agrif/bluegrass/README.md

Bluegrass Rev.1 Logo

This is an STM32 board (a la "Blue Pill") with built-in circuitry to charge
a single-cell lithium battery, over USB or DC input. It provides 5V and 3.3V
both at 1A, low standby current, battery fuel gauging, and supports charging
from a solar panel.
