agrif/bluegrass/logo/README.md

Bluegrass Rev.1 Logo

This logo uses [Wooden Nickel NF][] by [Nick Curtis][], with white
lines added on top for no better reason than I think they look nice
in PCB silkscreen. Nick makes nice fonts, and a ton of them are
free -- thank you Nick!

  [Wooden Nickel NF]: https://www.1001fonts.com/woodennickelblack-font.html
  [Nick Curtis]: https://www.nicksfonts.com/
