agrif/bluegrass/hardware/stm32-battery.kicad_pcb

## KiCad design hardware/stm32-battery.kicad_pcb (2022-09-16)

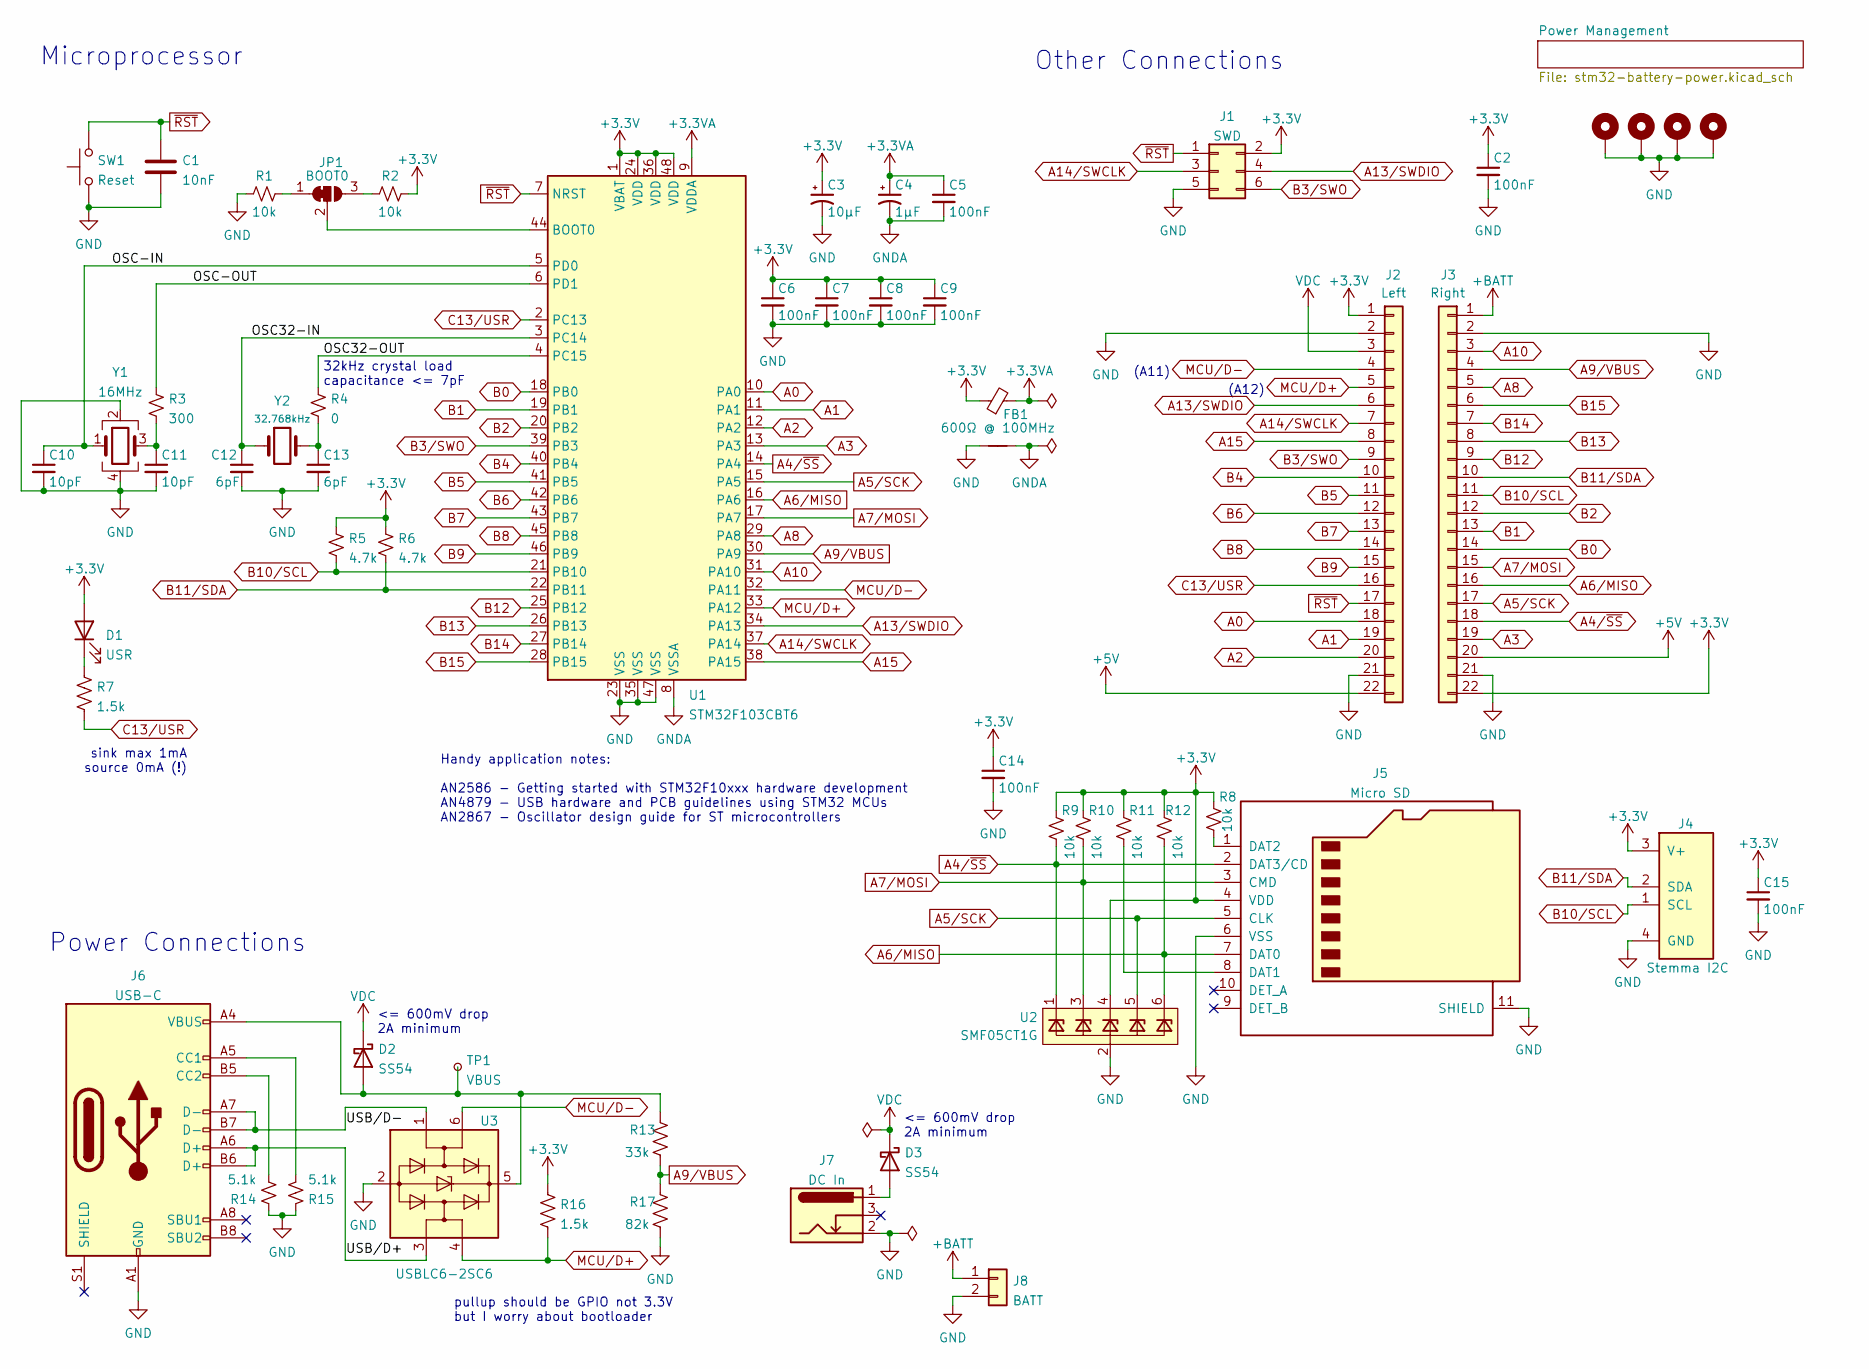
[picture p1: schematic stm32-battery.kicad_sch, STM32 with Battery]

Parts:
C1: 10nF; C_0805_2012Metric; LCSC Part # C1710
C2, C5, C6, C7, C8, C9, C14, C15: 100nF; C_0603_1608Metric; LCSC Part # C14663
C3: 10µF; C_0805_2012Metric; LCSC Part # C15850
C4: 1µF; C_0805_2012Metric; LCSC Part # C28323
C10, C11: 10pF; C_0603_1608Metric; LCSC Part # C1634
C12, C13: 6pF; C_0603_1608Metric; LCSC Part # C37474
D1: USR; LED_0805_2012Metric; LCSC Part # C2296
D2, D3: SS54; D_SMA; LCSC Part # C22452
FB1: 600Ω @ 100MHz; L_0805_2012Metric; LCSC Part # C1017
H1, H2, H3, H4: M3; MountingHole_3.2mm_M3_Pad
J1: SWD; PinHeader_2x03_P2.54mm_Vertical
J2: Left; PinHeader_1x22_P2.54mm_Vertical
J3: Right; PinHeader_1x22_P2.54mm_Vertical
J4: Stemma I2C; JST_PH_S4B-PH-K_1x04_P2.00mm_Horizontal; Digikey # S4B-PH-KL(LF)(SN)-ND
J5: Micro SD; SOFNG-TF-15x15; LCSC Part # C111196
J6: USB-C; USB_C_Receptacle_XKB_U262-16XN-4BVC11; LCSC Part # C319148
J7: DC In; BarrelJack_Horizontal; Mouser # 992-CON-SOCJ-2155; Digikey # 1939-G-014-4-ND
J8: BATT; JST_PH_S2B-PH-K_1x02_P2.00mm_Horizontal; Digikey # S2B-PH-K-S(LF)(SN)
JP1: BOOT0; SolderJumper-3_P1.3mm_Bridged12_RoundedPad1.0x1.5mm
NT1: NetTie_2; NetTie-2_SMD_Pad2.0mm
R1, R2, R8, R9, R10, R11, R12: 10k; R_0603_1608Metric; LCSC Part # C25804
R3: 300; R_0603_1608Metric; LCSC Part # C23025
R4: 0; R_0603_1608Metric; LCSC Part # C21189
R5, R6: 4.7k; R_0603_1608Metric; LCSC Part # C23162
R7, R16: 1.5k; R_0603_1608Metric; LCSC Part # C22843
R13: 33k; R_0603_1608Metric; LCSC Part # C4216
R14, R15: 5.1k; R_0603_1608Metric; LCSC Part # C23186
R17: 82k; R_0603_1608Metric; LCSC Part # C23254
SW1: Reset; TS-1187A-B-A-B; LCSC Part # C318884
TP1: VBUS; TestPoint_THTPad_D1.0mm_Drill0.5mm
U1: STM32F103CBT6; LQFP-48_7x7mm_P0.5mm; LCSC Part # C8304
U2: SMF05CT1G; SOT-363_SC-70-6; LCSC Part # C15879
U3: USBLC6-2SC6; SOT-23-6; LCSC Part # C2827654
Y1: 16MHz; Crystal_SMD_3225-4Pin_3.2x2.5mm; LCSC Part # C13738
Y2: 32.768kHz; Crystal_SMD_2012-2Pin_2.0x1.2mm; LCSC Part # C97602

Connections:
+3.3VA: C4.1, C5.1, FB1.2, U1.9 (VDDA)
+3V3: C2.1, C3.1, C6.1, C7.1, C8.1, C9.1, C14.1, C15.1, D1.2 (A), FB1.1, J1.2, J2.1, J3.22, J4.3 (V+), J5.4 (VDD), R2.2, R5.1, R6.1, R8.1, R9.1, R10.1, R11.1, R12.1, R16.1, U1.1 (VBAT), U1.24 (VDD), U1.36 (VDD), U1.48 (VDD), U2.4 (K); also elsewhere on the board
+5V: J2.22, J3.20; also elsewhere on the board
+BATT: J3.1, J8.1; also elsewhere on the board
/OSC32-IN: C12.1, U1.3 (PC14), Y2.1
/OSC32-OUT: R4.1, U1.4 (PC15)
/OSC-IN: C10.1, U1.5 (PD0), Y1.1
/OSC-OUT: R3.1, U1.6 (PD1)
/USB/D+: J6.A6 (D+), J6.B6 (D+), U3.3 (I/O2)
/USB/D-: J6.A7 (D-), J6.B7 (D-), U3.1 (I/O1)
A0: J2.18, U1.10 (PA0)
A1: J2.19, U1.11 (PA1)
A2: J2.20, U1.12 (PA2)
A3: J3.19, U1.13 (PA3)
A4/~SS: J3.18, J5.2 (DAT3/CD), R9.2, U1.14 (PA4), U2.1 (K)
A5/SCK: J3.17, J5.5 (CLK), U1.15 (PA5), U2.5 (K)
A6/MISO: J3.16, J5.7 (DAT0), R12.2, U1.16 (PA6), U2.6 (K)
A7/MOSI: J3.15, J5.3 (CMD), R10.2, U1.17 (PA7), U2.3 (K)
A8: J3.5, U1.29 (PA8)
A9/VBUS: J3.4, R13.2, R17.1, U1.30 (PA9)
A10: J3.3, U1.31 (PA10)
A13/SWDIO: J1.4, J2.6, U1.34 (PA13)
A14/SWCLK: J1.3, J2.7, U1.37 (PA14)
A15: J2.8, U1.38 (PA15)
B0: J3.14, U1.18 (PB0)
B1: J3.13, U1.19 (PB1)
B2: J3.12, U1.20 (PB2)
B3/SWO: J1.6, J2.9, U1.39 (PB3)
B4: J2.10, U1.40 (PB4)
B5: J2.11, U1.41 (PB5)
B6: J2.12, U1.42 (PB6)
B7: J2.13, U1.43 (PB7)
B8: J2.14, U1.45 (PB8)
B9: J2.15, U1.46 (PB9)
B10/SCL: J3.11, J4.1 (SCL), R5.2, U1.21 (PB10); also elsewhere on the board
B11/SDA: J3.10, J4.2 (SDA), R6.2, U1.22 (PB11); also elsewhere on the board
B12: J3.9, U1.25 (PB12)
B13: J3.8, U1.26 (PB13)
B14: J3.7, U1.27 (PB14)
B15: J3.6, U1.28 (PB15)
C13/USR: J2.16, R7.2, U1.2 (PC13)
GND: C1.2, C2.2, C3.2, C6.2, C7.2, C8.2, C9.2, C10.2, C11.2, C12.2, C13.2, C14.2, C15.2, H1.1, H2.1, H3.1, H4.1, J1.5, J2.2, J2.21, J3.2, J3.21, J4.4 (GND), J5.6 (VSS), J5.11 (SHIELD), J6.A1 (GND), J6.A12 (GND), J6.B1 (GND), J6.B12 (GND), J7.2, J8.2, NT1.1, R1.1, R14.1, R15.1, R17.2, SW1.1, U1.23 (VSS), U1.35 (VSS), U1.47 (VSS), U2.2 (A), U3.2 (GND), Y1.2, Y1.4; also elsewhere on the board
GNDA: C4.2, C5.2, NT1.2, U1.8 (VSSA)
MCU/D+: J2.5, R16.2, U1.33 (PA12), U3.4 (I/O2)
MCU/D-: J2.4, U1.32 (PA11), U3.6 (I/O1)
unnamed: C11.1, R3.2, Y1.3
unnamed: C13.1, R4.2, Y2.2
unnamed: D1.1 (K), R7.1
unnamed: D2.2 (A), J6.A4 (VBUS), J6.A9 (VBUS), J6.B4 (VBUS), J6.B9 (VBUS), R13.1, TP1.1, U3.5 (VBUS)
unnamed: D3.2 (A), J7.1
unnamed: J5.1 (DAT2), R8.2
unnamed: J5.8 (DAT1), R11.2
unnamed: J6.A5 (CC1), R15.2
unnamed: J6.B5 (CC2), R14.2
unnamed: JP1.1 (A), R1.2
unnamed: JP1.2 (C), U1.44 (BOOT0)
unnamed: JP1.3 (B), R2.1
VDC: D2.1 (K), D3.1 (K), J2.3; also elsewhere on the board
~RST: C1.1, J1.1, J2.17, SW1.2, U1.7 (NRST)

Notes on the sheet:
Power Connections
sink max 1mA source 0mA (!)
pullup should be GPIO not 3.3V but I worry about bootloader
(A12)
Other Connections
32kHz crystal load capacitance <= 7pF
Microprocessor
<= 600mV drop 2A minimum
Handy application notes: AN2586 - Getting started with STM32F10xxx hardware development AN4879 - USB hardware and PCB guidelines using STM32 MCUs AN2867 - Oscillator design guide for ST microcontrollers
(A11)

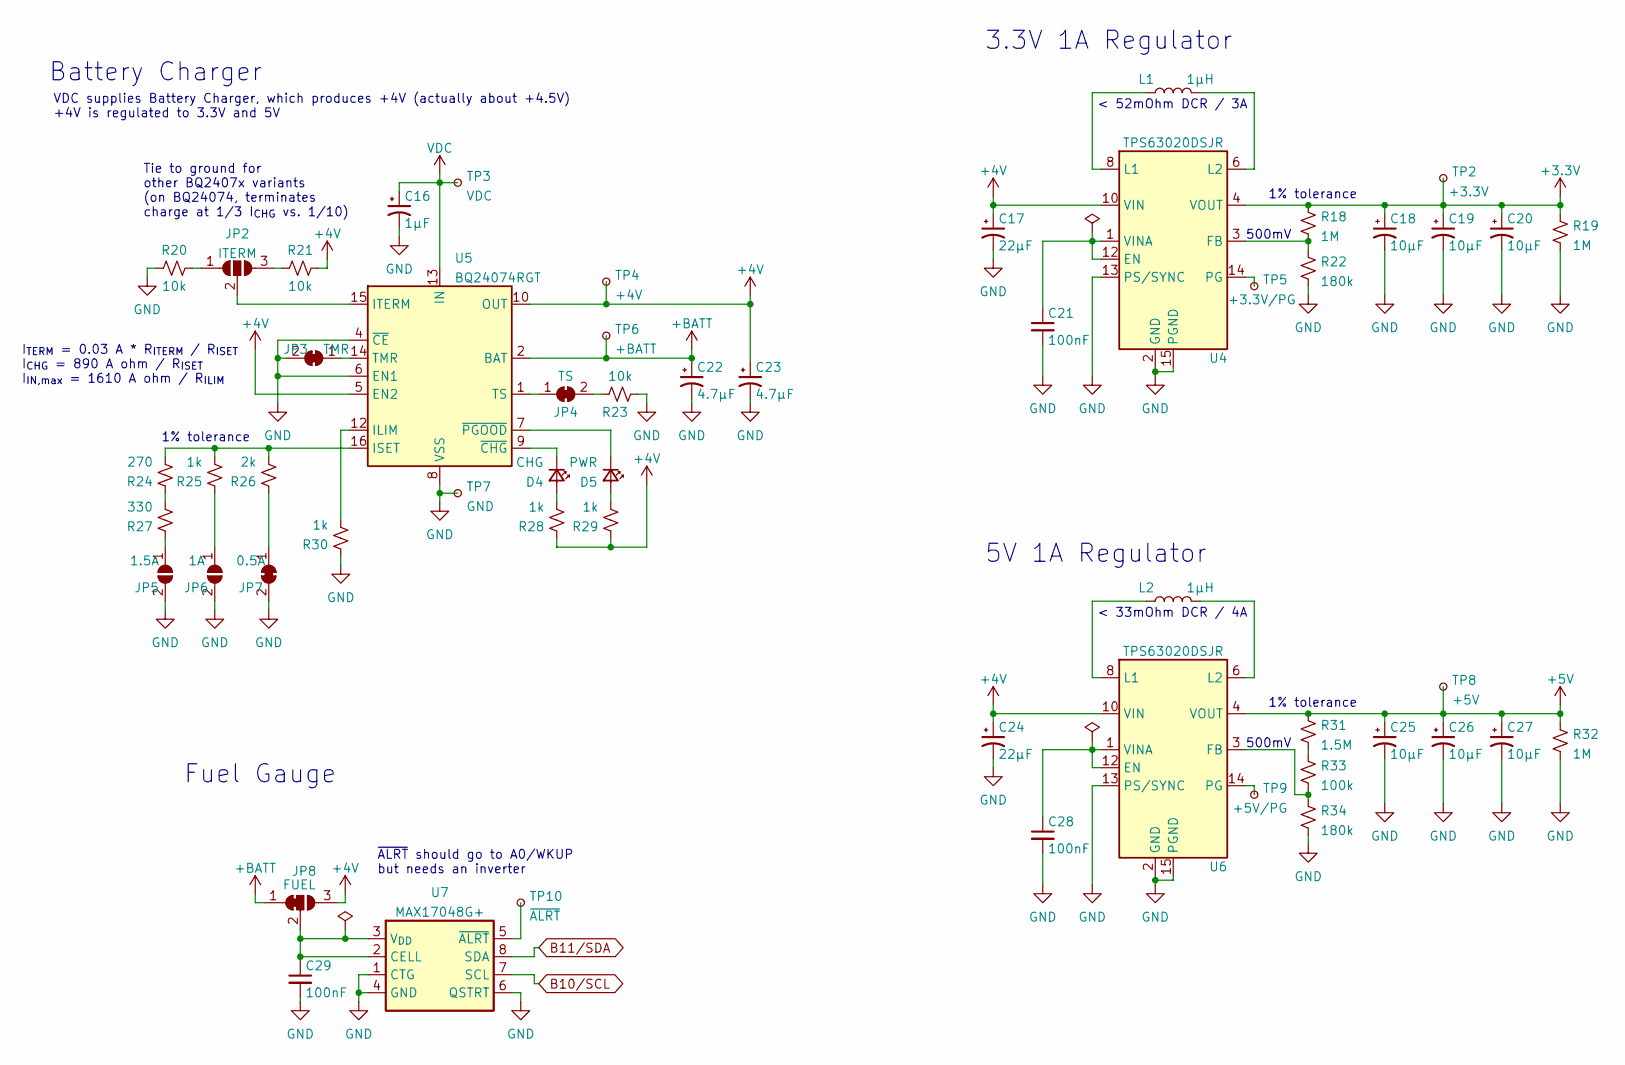
[picture p2: schematic stm32-battery-power.kicad_sch, STM32 with Battery]

Parts:
C16: 1µF; C_0805_2012Metric; LCSC Part # C28323
C17, C24: 22µF; C_1206_3216Metric; LCSC Part # C12891
C18, C19, C20, C25, C26, C27: 10µF; C_0805_2012Metric; LCSC Part # C15850
C21, C28, C29: 100nF; C_0603_1608Metric; LCSC Part # C14663
C22, C23: 4.7µF; C_0805_2012Metric; LCSC Part # C1779
D4: CHG; LED_0805_2012Metric; LCSC Part # C84256
D5: PWR; LED_0805_2012Metric; LCSC Part # C2297
JP2: ITERM; SolderJumper-3_P1.3mm_Open_RoundedPad1.0x1.5mm
JP3: TMR; SolderJumper-2_P1.3mm_Bridged_RoundedPad1.0x1.5mm
JP4: TS; SolderJumper-2_P1.3mm_Bridged_RoundedPad1.0x1.5mm
JP5: 1.5A; SolderJumper-2_P1.3mm_Open_RoundedPad1.0x1.5mm
JP6: 1A; SolderJumper-2_P1.3mm_Open_RoundedPad1.0x1.5mm
JP7: 0.5A; SolderJumper-2_P1.3mm_Bridged_RoundedPad1.0x1.5mm
JP8: FUEL; SolderJumper-3_P1.3mm_Bridged12_RoundedPad1.0x1.5mm
L1, L2: 1µH; SWPA6020S; LCSC Part # C98200
R18, R19, R32: 1M; R_0603_1608Metric; LCSC Part # C22935
R20, R21, R23: 10k; R_0603_1608Metric; LCSC Part # C25804
R22, R34: 180k; R_0603_1608Metric; LCSC Part # C22827
R24: 270; R_0603_1608Metric; LCSC Part # C22966
R25, R28, R29, R30: 1k; R_0603_1608Metric; LCSC Part # C21190
R26: 2k; R_0603_1608Metric; LCSC Part # C22975
R27: 330; R_0603_1608Metric; LCSC Part # C23138
R31: 1.5M; R_0603_1608Metric; LCSC Part # C4172
R33: 100k; R_0603_1608Metric; LCSC Part # C25803
TP2: +3.3V; TestPoint_THTPad_D1.0mm_Drill0.5mm
TP3: VDC; TestPoint_THTPad_D1.0mm_Drill0.5mm
TP4: +4V; TestPoint_THTPad_D1.0mm_Drill0.5mm
TP5: +3.3V/PG; TestPoint_THTPad_D1.0mm_Drill0.5mm
TP6: +BATT; TestPoint_THTPad_D1.0mm_Drill0.5mm
TP7: GND; TestPoint_THTPad_1.0x1.0mm_Drill0.5mm
TP8: +5V; TestPoint_THTPad_D1.0mm_Drill0.5mm
TP9: +5V/PG; TestPoint_THTPad_D1.0mm_Drill0.5mm
TP10: ~{ALRT}; TestPoint_THTPad_D1.0mm_Drill0.5mm
U4, U6: TPS63020DSJR; Texas_R-PVSON-N14_ThermalVias; LCSC Part # C15483
U5: BQ24074RGT; VQFN-16-1EP_3x3mm_P0.5mm_EP1.6x1.6mm_ThermalVias; LCSC Part # C54313
U7: MAX17048G+; MAX17048-TDFN-8; LCSC Part # C2682616

Connections:
+3V3: C18.1, C19.1, C20.1, R18.1, R19.1, TP2.1, U4.4 (VOUT), U4.5 (VOUT); also elsewhere on the board
+4V: C17.1, C23.1, C24.1, JP8.3 (B), R21.2, R28.1, R29.1, TP4.1, U4.10 (VIN), U4.11 (VIN), U5.5 (EN2), U5.10 (OUT), U5.11 (OUT), U6.10 (VIN), U6.11 (VIN)
+5V: C25.1, C26.1, C27.1, R31.1, R32.1, TP8.1, U6.4 (VOUT), U6.5 (VOUT); also elsewhere on the board
+BATT: C22.1, JP8.1 (A), TP6.1, U5.2 (BAT), U5.3 (BAT); also elsewhere on the board
B10/SCL: U7.7 (SCL); also elsewhere on the board
B11/SDA: U7.8 (SDA); also elsewhere on the board
GND: C16.2, C17.2, C18.2, C19.2, C20.2, C21.2, C22.2, C23.2, C24.2, C25.2, C26.2, C27.2, C28.2, C29.2, JP3.2 (B), JP5.2 (B), JP6.2 (B), JP7.2 (B), R19.2, R20.1, R22.2, R23.2, R30.1, R32.2, R34.2, TP7.1, U4.2 (GND), U4.13 (PS/SYNC), U4.15 (PGND), U5.4 (~CE), U5.6 (EN1), U5.8 (VSS), U5.17 (VSS), U6.2 (GND), U6.13 (PS/SYNC), U6.15 (PGND), U7.1 (CTG), U7.4 (GND), U7.6 (QSTRT); also elsewhere on the board
unnamed: C21.1, U4.1 (VINA), U4.12 (EN)
unnamed: C28.1, U6.1 (VINA), U6.12 (EN)
unnamed: C29.1, JP8.2 (C), U7.2 (CELL), U7.3 (V_{DD})
unnamed: D4.1 (K), U5.9 (~CHG)
unnamed: D4.2 (A), R28.2
unnamed: D5.1 (K), U5.7 (~PGOOD)
unnamed: D5.2 (A), R29.2
unnamed: JP2.1 (A), R20.2
unnamed: JP2.2 (C), U5.15 (ITERM)
unnamed: JP2.3 (B), R21.1
unnamed: JP3.1 (A), U5.14 (TMR)
unnamed: JP4.1 (A), U5.1 (TS)
unnamed: JP4.2 (B), R23.1
unnamed: JP5.1 (A), R27.1
unnamed: JP6.1 (A), R25.1
unnamed: JP7.1 (A), R26.1
unnamed: L1.1, U4.8 (L1), U4.9 (L1)
unnamed: L1.2, U4.6 (L2), U4.7 (L2)
unnamed: L2.1, U6.8 (L1), U6.9 (L1)
unnamed: L2.2, U6.6 (L2), U6.7 (L2)
unnamed: R18.2, R22.1, U4.3 (FB)
unnamed: R24.1, R27.2
unnamed: R24.2, R25.2, R26.2, U5.16 (ISET)
unnamed: R30.2, U5.12 (ILIM)
unnamed: R31.2, R33.1
unnamed: R33.2, R34.1, U6.3 (FB)
unnamed: TP5.1, U4.14 (PG)
unnamed: TP9.1, U6.14 (PG)
unnamed: TP10.1, U7.5 (~ALRT)
VDC: C16.1, TP3.1, U5.13 (IN); also elsewhere on the board

Notes on the sheet:
Fuel Gauge
1% tolerance
5V 1A Regulator
VDC supplies Battery Charger, which produces +4V (actually about +4.5V) +4V is regulated to 3.3V and 5V
500mV
~{ALRT} should go to A0/WKUP but needs an inverter
< 33mOhm DCR / 4A
< 52mOhm DCR / 3A
I_{TERM} = 0.03 A * R_{ITERM} / R_{ISET} I_{CHG} = 890 A ohm / R_{ISET} I_{IN,max} = 1610 A ohm / R_{ILIM}
Tie to ground for other BQ2407x variants (on BQ24074, terminates charge at 1/3 I_{CHG} vs. 1/10)
3.3V 1A Regulator
Battery Charger

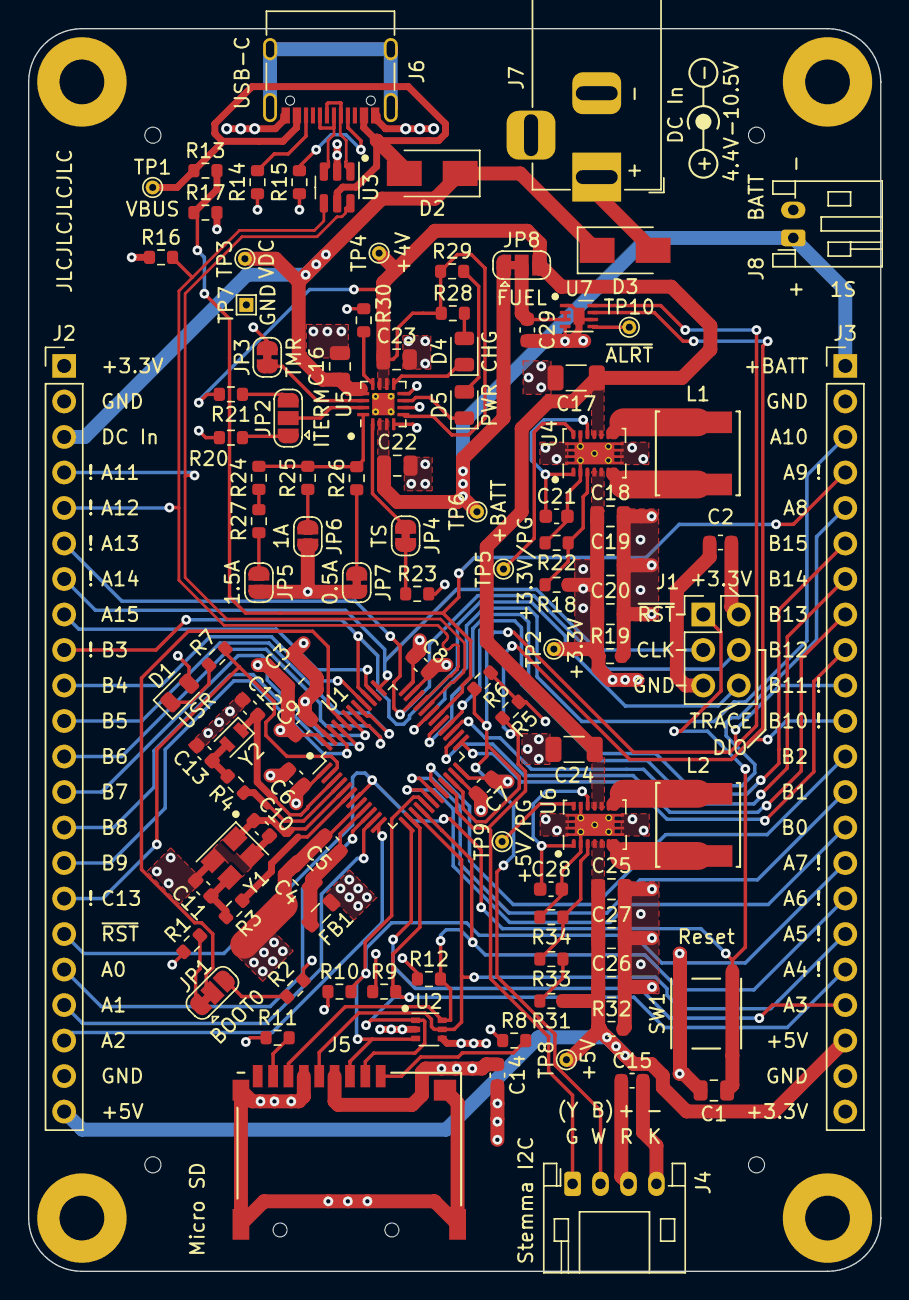
[picture p3: board stm32-battery.kicad_pcb from above]

Board: 4 copper layers, 61.0 x 88.9 mm, 113 parts (1 on the bottom side), 89 nets.

Other parts of the board:
Ref**: Val**; Rakeri-10mm
