agrif/bluegrass/battery-logger/variants/bluegrass_rev1/variant_BLUEGRASS_REV1.cpp

/*
 *******************************************************************************
 * Copyright (c) 2018-2021, STMicroelectronics
 * All rights reserved.
 *
 * This software component is licensed by ST under BSD 3-Clause license,
 * the "License"; You may not use this file except in compliance with the
 * License. You may obtain a copy of the License at:
 *                        opensource.org/licenses/BSD-3-Clause
 *
 *******************************************************************************
 */

#include "pins_arduino.h"
// Pin number
const PinName digitalPin[] = {
  /* USB connector on the top, MCU side */
  /* Left Side */
  PB_9,  //D0
  PB_8,  //D1
  PB_7,  //D2
  PB_6,  //D3
  PB_5,  //D4
  PB_4,  //D5
  PB_3,  //D6
  PA_15, //D7
  PA_12, //D8 - USB DP
  PA_11, //D9 - USB DM
  PA_10, //D10
  PA_9,  //D11
  PA_8,  //D12
  PB_15, //D13
  PB_14, //D14
  PB_13, //D15
  PB_12, //D16 - LED Blackpill
  /* Right side */
  PC_13, //D17 - LED Bluepill
  PC_14, //D18
  PC_15, //D19
  PA_0,  //D20/A0
  PA_1,  //D21/A1
  PA_2,  //D22/A2
  PA_3,  //D23/A3
  PA_4,  //D24/A4
  PA_5,  //D25/A5
  PA_6,  //D26/A6
  PA_7,  //D27/A7
  PB_0,  //D28/A8
  PB_1,  //D29/A9
  PB_10, //D30
  PB_11, //D31
  PB_2,  //D32 - BOOT1
  PA_13, //D33 - SWDI0
  PA_14, //D34 - SWCLK
};

// Analog (Ax) pin number array
const uint32_t analogInputPin[] = {
  20, // A0
  21, // A1
  22, // A2
  23, // A3
  24, // A4
  25, // A5
  26, // A6
  27, // A7
  28, // A8
  29  // A9
};

// ----------------------------------------------------------------------------

#ifdef __cplusplus
extern "C" {
#endif

/**
  * @brief  System Clock Configuration
  *         The system Clock is configured as follow :
  *            System Clock source            = PLL (HSE)
  *            HSE Prediv Value               = 2
  *            SYSCLK(Hz)                     = 72000000
  *            HCLK(Hz)                       = 72000000
  *            AHB Prescaler                  = 1
  *            APB1 Prescaler                 = 2
  *            APB2 Prescaler                 = 1
  *            PLL_Source                     = HSE
  *            PLL_Mul                        = 9
  *            Flash Latency(WS)              = 2
  *            ADC Prescaler                  = 2
  *            USB Prescaler                  = 1.5
  * (!!! DO NOT TRUST THESE VALUES, I DON'T KNOW WHAT I'M DOING !!!)
  * @param  None
  * @retval None
  */
WEAK void SystemClock_Config(void)
{
  RCC_OscInitTypeDef RCC_OscInitStruct = {0};
  RCC_ClkInitTypeDef RCC_ClkInitStruct = {0};
  RCC_PeriphCLKInitTypeDef PeriphClkInit = {0};

  /** Initializes the RCC Oscillators according to the specified parameters
  * in the RCC_OscInitTypeDef structure.
  */
  RCC_OscInitStruct.OscillatorType = RCC_OSCILLATORTYPE_HSE;
  RCC_OscInitStruct.HSEState = RCC_HSE_ON;
  RCC_OscInitStruct.HSEPredivValue = RCC_HSE_PREDIV_DIV2;
  RCC_OscInitStruct.HSIState = RCC_HSI_ON;
  RCC_OscInitStruct.PLL.PLLState = RCC_PLL_ON;
  RCC_OscInitStruct.PLL.PLLSource = RCC_PLLSOURCE_HSE;
  RCC_OscInitStruct.PLL.PLLMUL = RCC_PLL_MUL9;
  if (HAL_RCC_OscConfig(&RCC_OscInitStruct) != HAL_OK)
  {
    Error_Handler();
  }

  /** Initializes the CPU, AHB and APB buses clocks
  */
  RCC_ClkInitStruct.ClockType = RCC_CLOCKTYPE_HCLK|RCC_CLOCKTYPE_SYSCLK
                              |RCC_CLOCKTYPE_PCLK1|RCC_CLOCKTYPE_PCLK2;
  RCC_ClkInitStruct.SYSCLKSource = RCC_SYSCLKSOURCE_PLLCLK;
  RCC_ClkInitStruct.AHBCLKDivider = RCC_SYSCLK_DIV1;
  RCC_ClkInitStruct.APB1CLKDivider = RCC_HCLK_DIV2;
  RCC_ClkInitStruct.APB2CLKDivider = RCC_HCLK_DIV1;

  if (HAL_RCC_ClockConfig(&RCC_ClkInitStruct, FLASH_LATENCY_2) != HAL_OK)
  {
    Error_Handler();
  }
  PeriphClkInit.PeriphClockSelection = RCC_PERIPHCLK_USB;
  PeriphClkInit.UsbClockSelection = RCC_USBCLKSOURCE_PLL_DIV1_5;
  if (HAL_RCCEx_PeriphCLKConfig(&PeriphClkInit) != HAL_OK)
  {
    Error_Handler();
  }
}

#ifdef __cplusplus
}
#endif
