agrif/bluegrass/(commit log)

2022-09-16 jlcpcb order #, tooling, export
    [stm32-battery-power.kicad_sch, stm32-battery.kicad_pcb, stm32-battery.kicad_sch]
2022-09-28 part numbers for jst connectors / dc barrel jac
    [stm32-battery.kicad_sch]
2022-10-03 move kicad stuff into subdirectory, new name
    [stm32-battery-power.kicad_sch, stm32-battery.kicad_pcb, stm32-battery.kicad_sch]
2022-10-15 kitchensink: use pulldown on vbus pin
2022-11-25 battery-logger: added a low-power logging example
2022-11-26 kitchensink: add a note about LSE/RTC failure
    [Rtc.cpp]
2022-11-27 kitchensink: morse code led
2022-11-27 kitchensink: ignore unhandled non-printable input
2022-11-27 kitchensink: print id number in banner
2022-11-29 kitchensink: low power sleeps
2022-11-30 battery-logger: temperature and morse heartbeat
2022-11-30 battery-logger: use delay not sleep in morse
